CharlyDucrocq/RouletteAuto/README.md

# RouletteAuto
Polytech logo logo polytech

Ce projet est réalisé dans le cadre de la 2ème année de formation de la prépa intégrée de Polytech'Nice Sophia. 

## Description du projet

Le but de ce projet est de concevoir, dévellopper et réaliser une roulette (type casino) qui fonctionnerait automatiquement. Seront alors à immaginer :
- un système de detection de la mise;
- un système de lancement de la roue et de la bille;
- un système de capture du resultat du lancé et de recupération de la bille;
- un système de distribution des éventuelles gains;
