CharlyDucrocq/RouletteAuto/Rapports s-ances/Rapports Charly/Rapport du 19.01.14.md

Déroulement de la séance :

Cette séance et la suivante seront réservé a l'assemblage des differentes pieces de la roue (roue, moteur, capteur, ect...).
En effectuant quelques tests j'ai pu observer que le moteur tourne beaucoup trop vite mais n'as pas la force necessaire afin de (directement) faire tourner doucement la roue avec son poid. De ce fait, il faudra transformer cette vitesse en force a l'aide d'une courroie.
Peu de chose a ajouter, ça reste du bricolage.

Objectif durant la prochaine séance :

- Terminer l'assemblage
- Commencer la programmation
