CharlyDucrocq/RouletteAuto/Rapports s-ances/Rapports Charly/Rapport du 18.12.17.md

Objectif de la séance :

- Experimentation du capteur IR pour la detection de la boule sur modèle en carton 
- Construction representation 3D de la roulette sur Autodesk
- Presparation d'une fonction "pousser" pour le servomoteur qui poussera la boule

Deroulement de la séance :

Les Objectif ont tous était tous était remplie sans difficulté. Le capteur diserne bien la difference entre le trou vide/le scotch noir et la boule (voir image).
Cette séance a plutot était utilisé afin de reflechir à la mise en forme du prototype de la roue et à combinaison de celui ci avec les composant. En effet, sans le prototype rien de concret n'est réaliseable car l'utilisation des composant electonique ne prend sens que conbiné à celle-ci. On a aussi reflechis à la combinaison moteur courantContinue/capteur/"pousseur" et comment faire pour passer d'une étape à l'autre. On a conclue à l'utilisation d'un solenoide pour bloquer la roue.
L'objectif principal pour l'instant sera la conception du prototype. Objectif FabLab ! 

Ci-dessous des image du modele carton et de la modelisation :

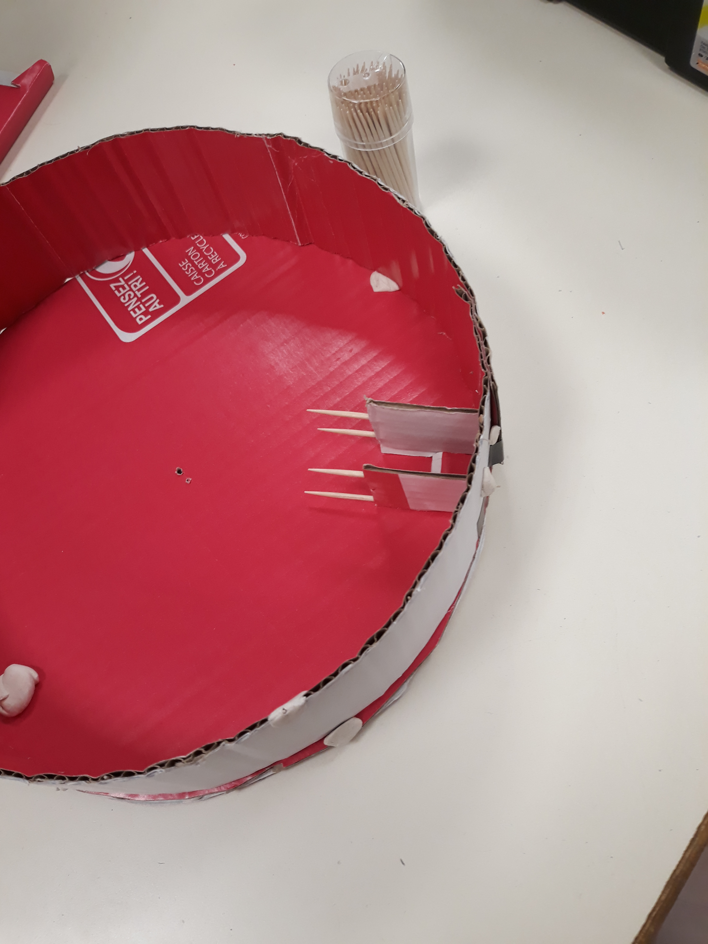
[picture p1: Documents/Images/20181217_164127.jpg]
Modele carton(1)

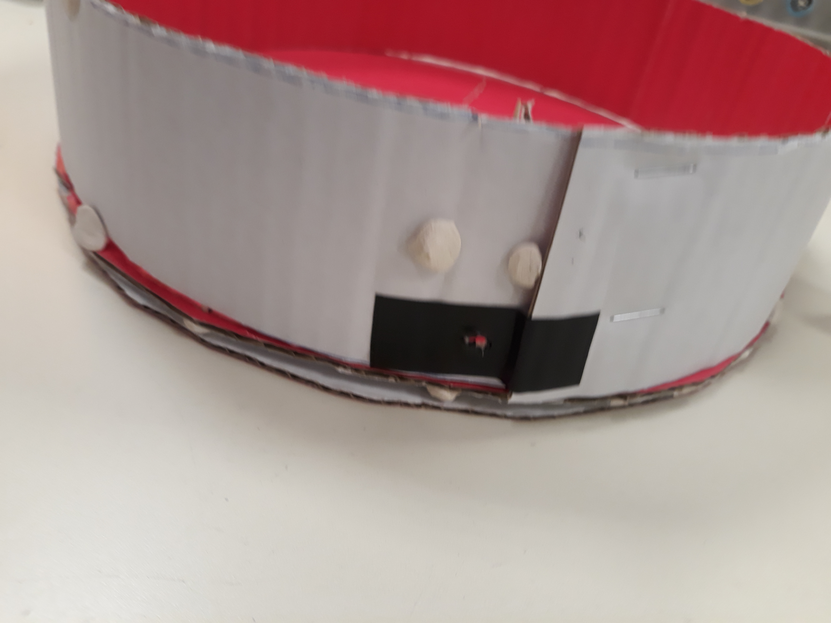
[picture p2: Documents/Images/20181217_164131.jpg]
Modele carton(2)

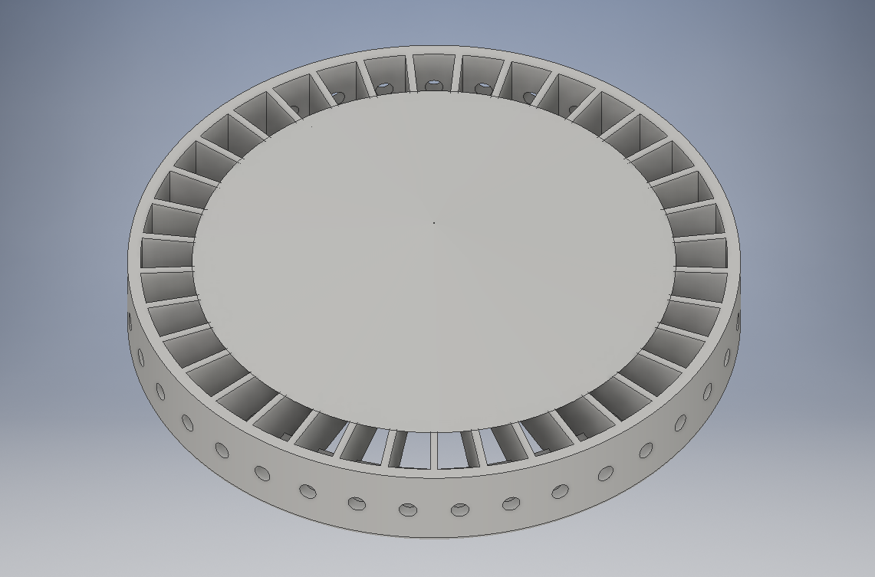
[picture p3: Documents/Images/Capture d’écran (10).png]
Modelisation entier

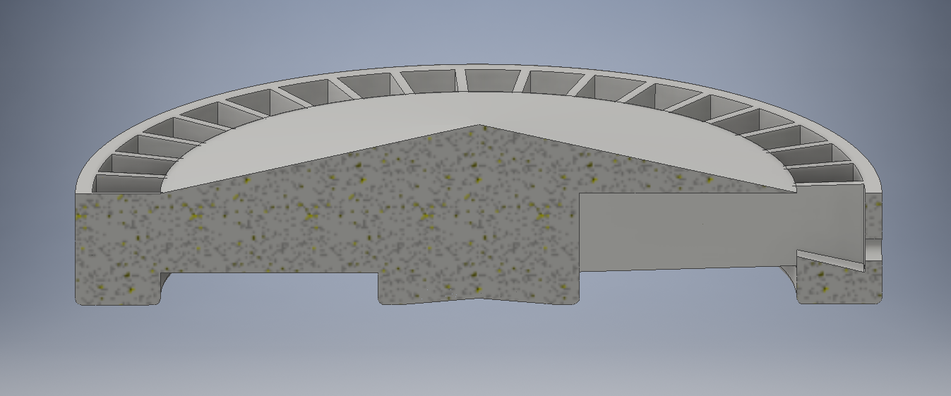
[picture p4: Documents/Images/Capture d’écran (11).png]
Modelisation coupe


Résumé de la séance :

- Experimentation du capteur IR pour la detection de la boule sur modèle en carton  Objectif remplie
- Construction representation 3D de la roulette sur Autodesk                        Objectif remplie
- Presparation d'une fonction "pousser" pour le servomoteur qui poussera la boule   Objectif remplie
