CharlyDucrocq/RouletteAuto/Rapports s-ances/Rapports Charly/Rapport du 19.02.27.md

Deroulement de la scéance :

Toujours dans la continuité des scéance precédente, j'ai avancé sur le prototype :

- j'ai placé les roues qui permettent à la roulette de rouler droit.
- j'ai fixé le capteur de proximité (pour la bille) .
- j'ai testé la pompe. Malheureusement, son souffle est beaucoup trop faible pour pousser la bille. De ce fait, on va devoir revenir à notre idée de base du pousseur.
- Durant cette semaine je compte aussi allé au fablab afin de finaliser la roulette : percer les trous entre capteur et bille et placer les cale en bois (qui permettent à la bille de rester contre la parroi). Il est prevu que j'y aille demain (voir plus bas pour plus d'information concernant son deroulement).
- Depuis la dernière séance, je me suis penché sur la programmation. Cependant, pour l'instant, cela ressemble plus à un croquis de programme car il me manque beaucoup de valeur experimentale que je ne peut pas prendre tant que le prototype n'est pas completé (temps que met la roulette afin que l'aimant passe d'un capteur à un autre, angle de "freinage" quand on arrete le moteur à un certaine vitesse, ...)

Ci-dessous, les photo de l'avancée de l'assemblage post-séance :

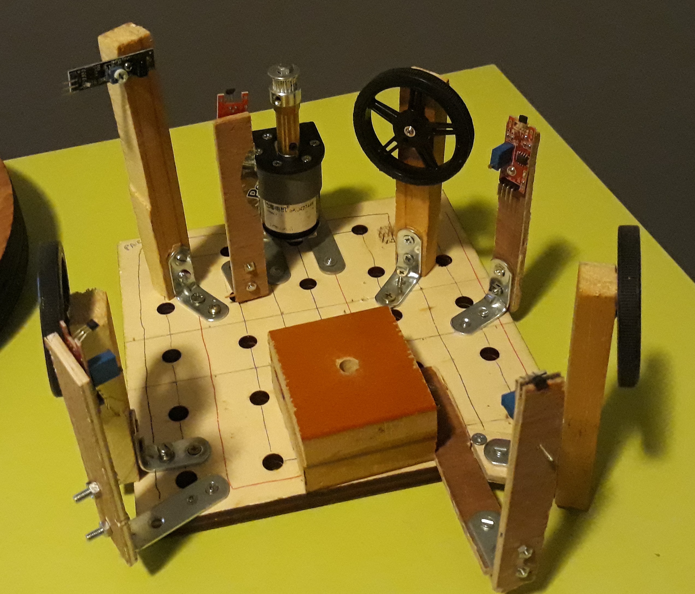
[picture p5: Documents/Images/20190227_194511[1].jpg]
Avancement actuel_sansRoue

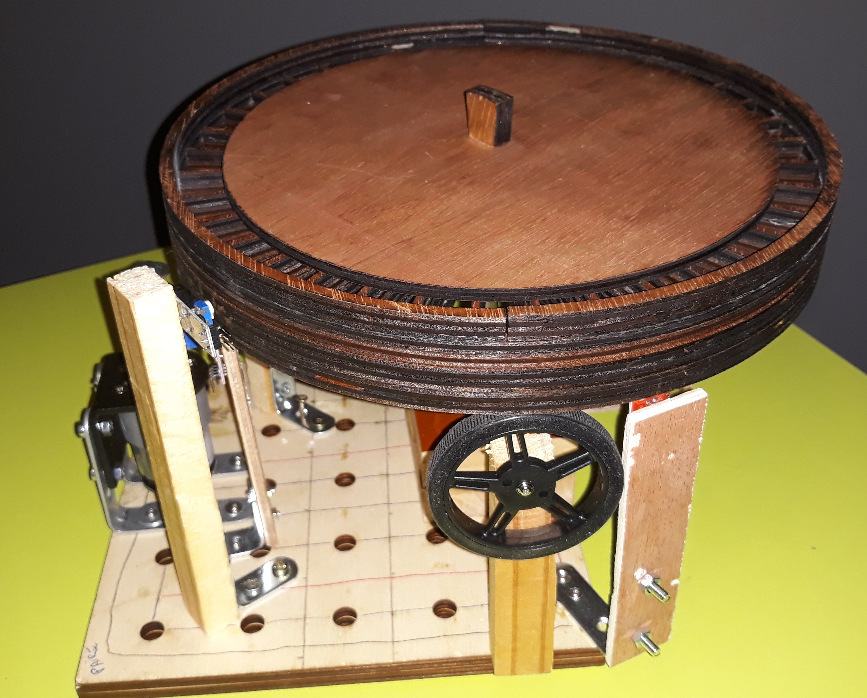
[picture p6: Documents/Images/20190227_194537[1].jpg]
Avancement actuel_avecRoue


Ajout post-fablab :

- Touts les trous sont percés, toutes les cales sont placés, la roulette est terminer (physiquement parlant)! 

Ci-dessous une photo de la roulette post-fablab :

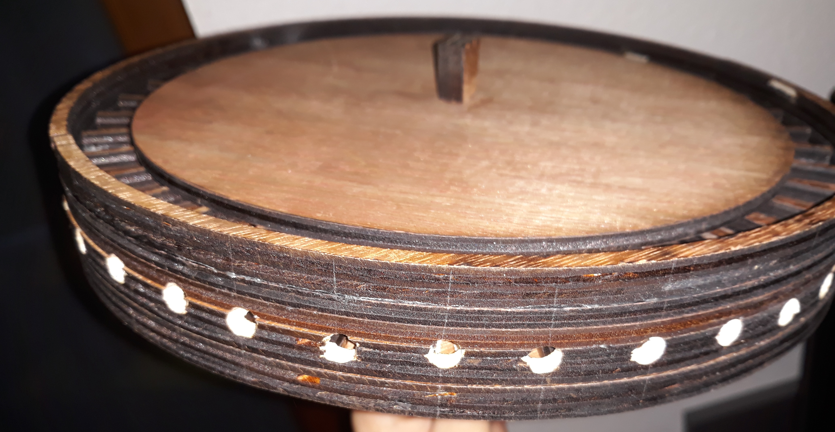
[picture p7: Documents/Images/20190228_182800[1].jpg]
Avancement fablab


Objectif pour la prochaine scéance :

Etant la dernière scéance, le planning s'annonce serré. 
La priorité sera de faire fonctionner un programme qui nous retournera l'emplacement de la bille. 
Pour ce qui est du pousseur, on verra si on a le temps... mais de ce que j'ai vu des différences attente/réalité des temps de production, cela semble compromis.
