CharlyDucrocq/RouletteAuto/Rapports s-ances/Rapports Charly/Rapport du 19.02.13.md

Deroulement de la scéance :

Dans la continuité des scéances précédente, j'ai avancé sur la conception du prototype:
  - J'ai poncé un trou dans lequel j'ai collé l'aimant qui servira de repere pour les capteur. (voir photo)
  - J'ai bricololé et ficé les support des 4 capteurs d'aimant fixé tous les 90° de la roue.
  - Mr. MASSON à reussi à nous procuré une pompe à air pour souffler la bille. Je n'ai pas eu le temps de faire de test de celui-ci mais j'ai de grand espoir quand à son efficacité.

Ce qu'il reste à faire sur la construction : 
- Fixation des roue qui stabiliseront la roulette
- Test et fixation du souffleur
- Fixation du capteur de proximité
- Cablage

Photos de l'avancé du prototype : 

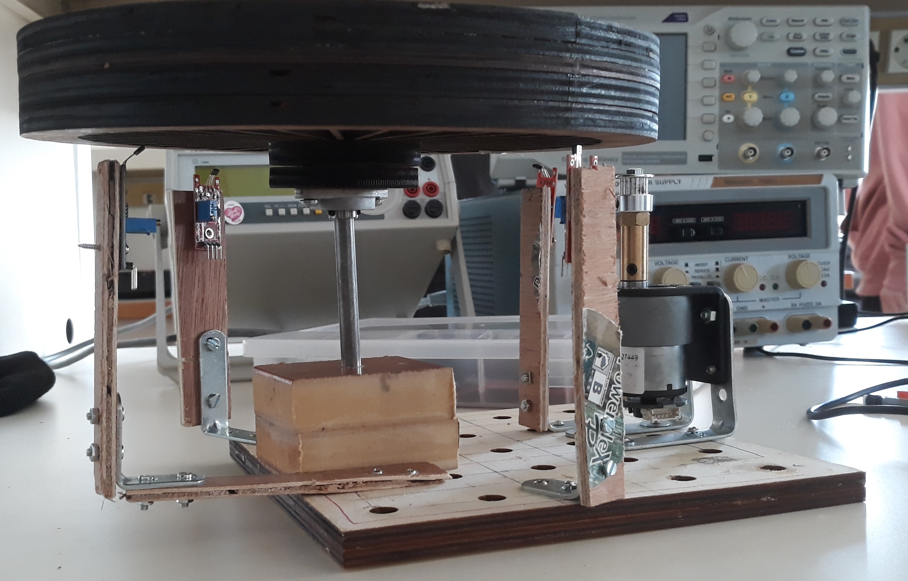
[picture p8: Documents/Images/20190213_125716.jpg]
Avancement actuel_proto

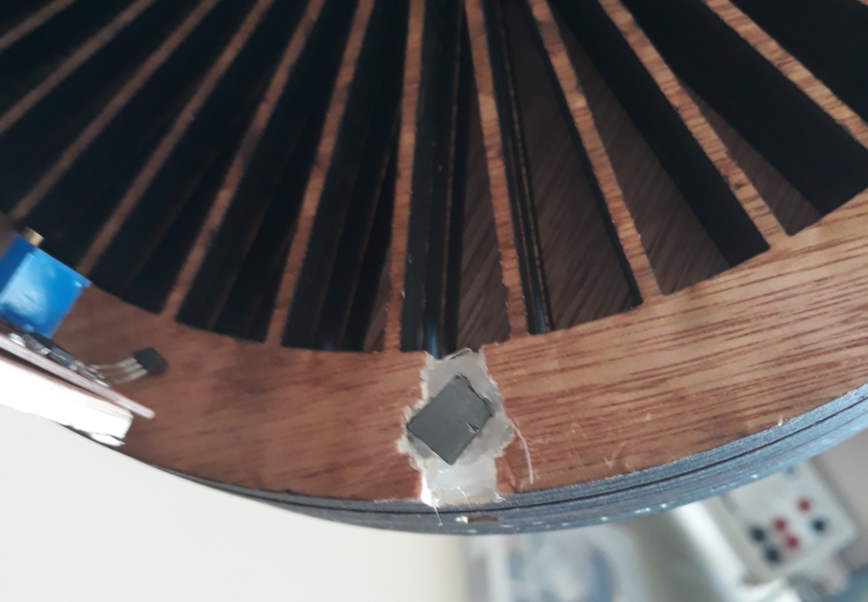
[picture p9: Documents/Images/20190213_125725.jpg]
Avancement actuel_amant
