CharlyDucrocq/RouletteAuto/Rapports s-ances/Rapports Charly/Rapport du 19.02.06.md

Déroulement de la séance :

- Durant cette séance, j'ai continué l'assemblage des pièces. Entre temps, je suis allé au fablab afin de préparer le nécessaire pour l'utilisation de la courroie : decoupe d'un "engrenage" (avec de petite dent pour s'accrocher à la courroie) à fixer sous la roue et ajustement d'une barre de fer qui sera le lien entre le support et le roulement à bille fixé sous la roue.
- La roue est maintenant bien fixé et après quelque essaie, le système de courroie semble apporté une vitesse suffisament lente comme désiré.
- J'ai aussi commencé a creusé un emplacement sous la roue afin d'y placer l'aiment. De plus, du fait de la bancalité du roulement à bille, la roue ne tourne pas toujours parfaitement droite, pour y remedier il faudra placer 2 ou 3 roue sous la roue pour la maintenir. 
- Après reflexion, il m'est aussi venu a l'idée un autre moyen pour éjecter la bille : au lieu d'utiliser un "pousseur" physique qui demandera une grande précision afin de le passer dans le trou, j'ai penser à utiliser un flux d'air qui souflerait la bille, très légère, de son emplacement par ce même trou. Ceci simplifierait grandement le mecanisme car il suffirait de souffler continuellement sur le coté de la roue en la faisant tourner jusqu'à que le souffle passe par le bon trou. Malheureusement, les dispositifs déjà sur place sont trop faible afin de pousser la bille, il faudrait donc trouver et commander un autre dispositif plus puissant ou sinon revenir sur l'idée précedente du "pousseur".

Ci-dessous des photos de l'assemblage jusqu'à maintenant :

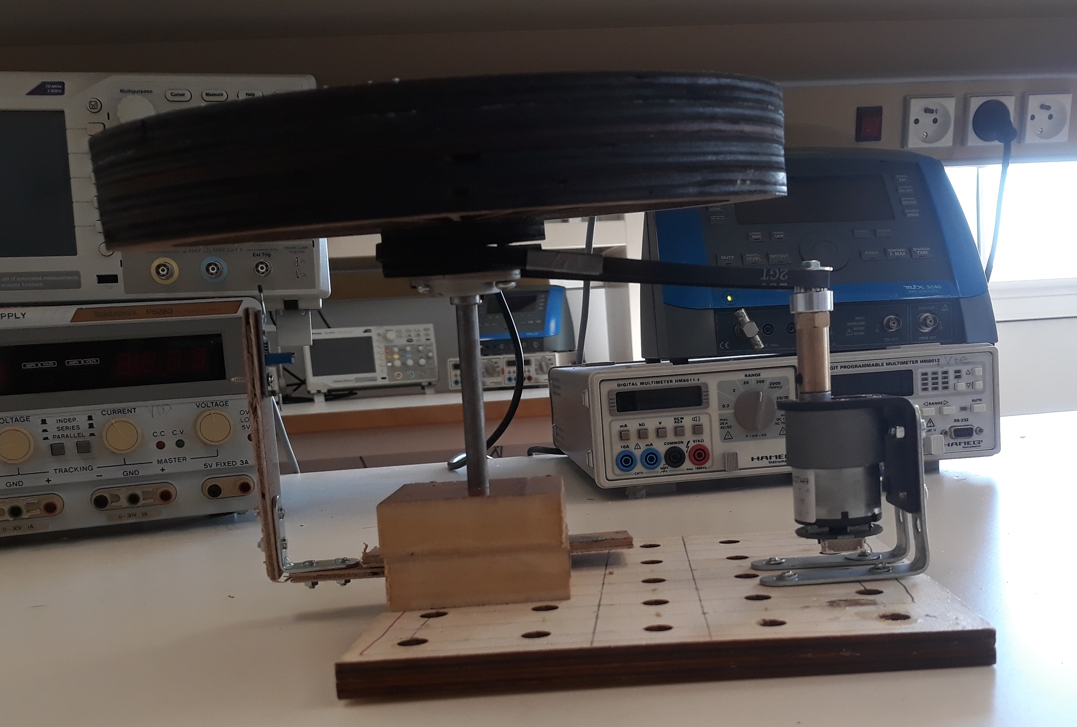
[picture p10: Documents/Images/20190206_131537.jpg]
Avancement actuel_1

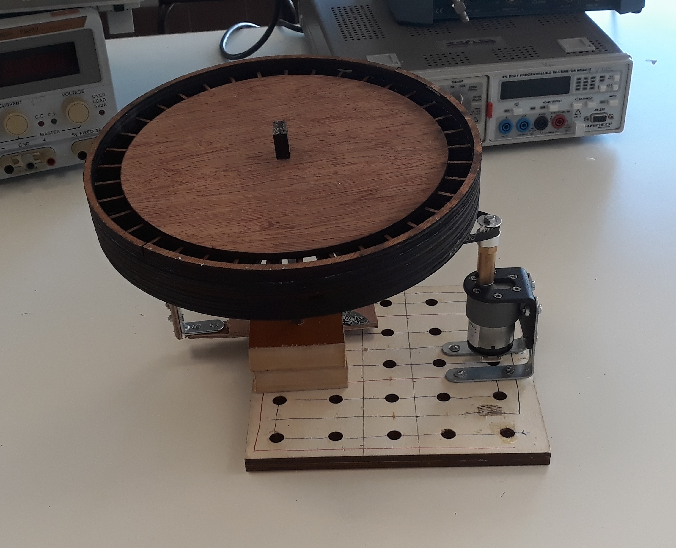
[picture p11: Documents/Images/20190206_131543.jpg]
Avancement actuel_2
