CharlyDucrocq/RouletteAuto/Rapports s-ances/Rapports Charly/Rapport du 19.01.09.md

Objectif de la séance :

- Preparation des patron pour la construction du prototype

Deroulement de la séance :

Un rdv au fablab a était prevue pour le mardi 10/01. en vue de l'optimisation de son utilisation, la séance a été dans mon cas alloué à sa preparation. Au départ j'étais partie sur des patron papier, pensant que la decoupe se ferait a la main. Cependant, au conseil d'un collegue, je me suis orienter vers un logiciel appelé Inkscape, permettant d'utiliser la decoupeuse laser.  

Ci-dessous des image Inkscape :

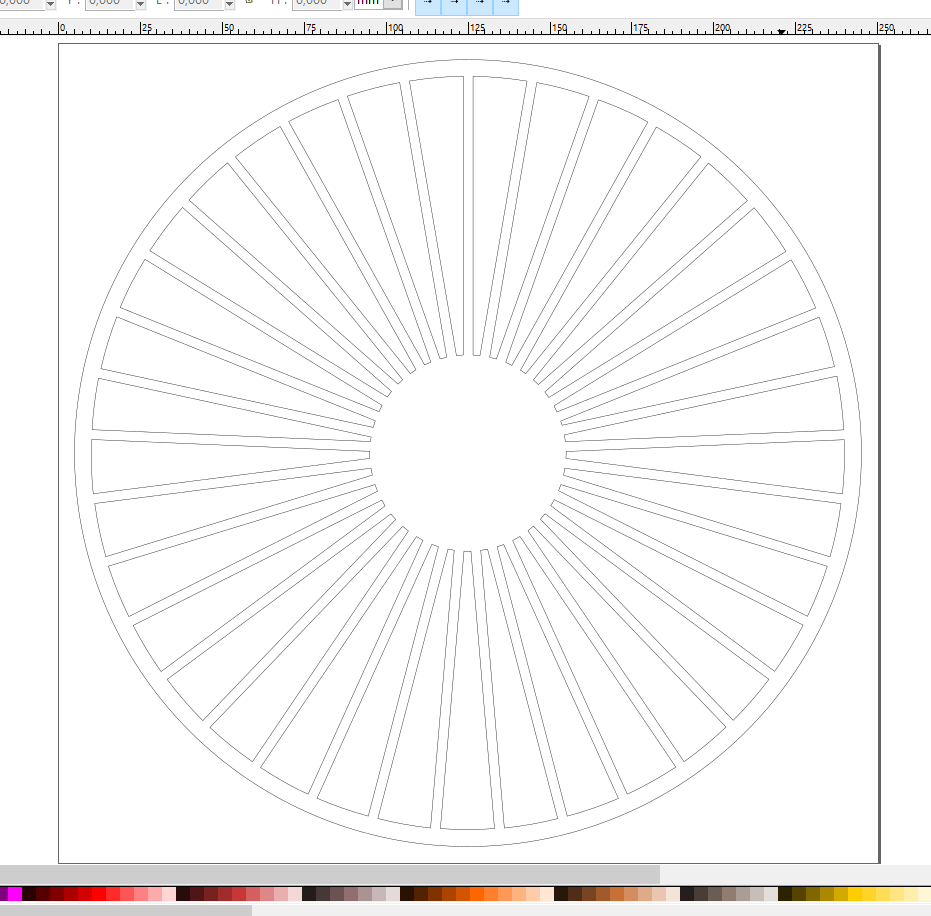
[picture p12: Documents/Images/Capture d’écran (14).png]
Roue interne

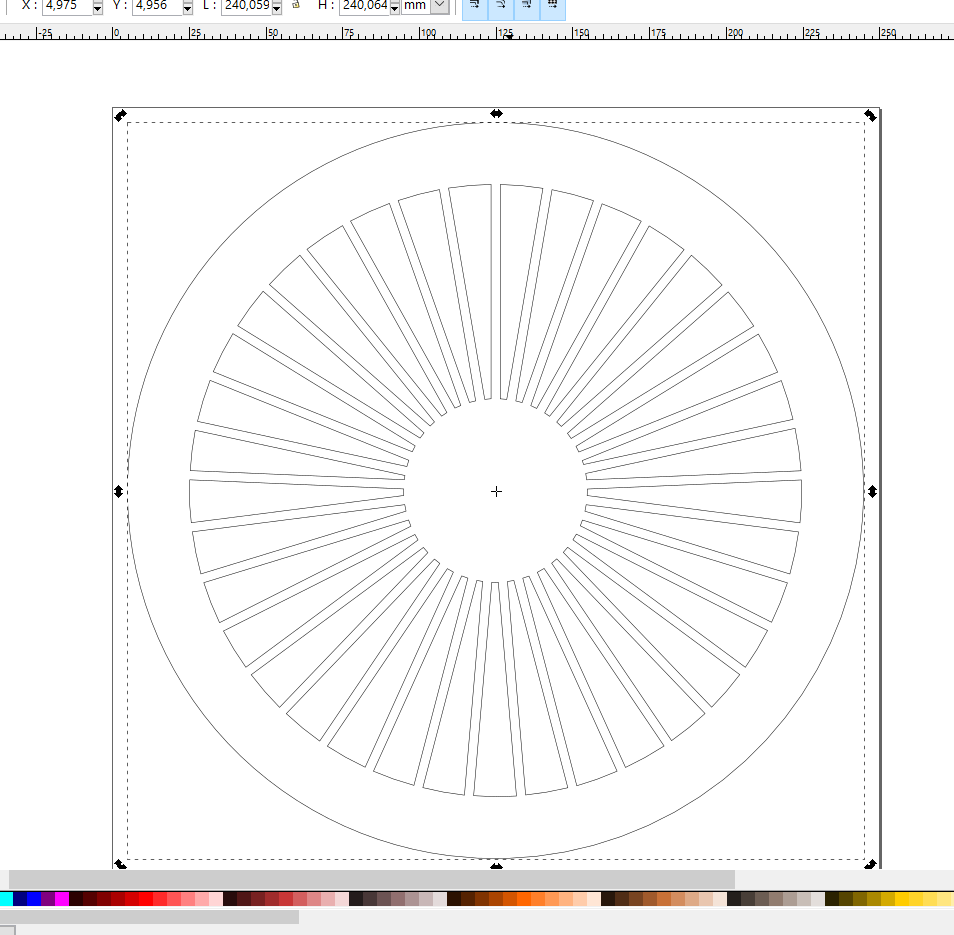
[picture p13: Documents/Images/Capture d’écran (13).png]
Roue dessous


----------------------------------------------------

Ajout post-fablab du 10/01:

La preparation du prototype a bien avancé. Il ne manque plus qu'un etage pour atteindre une hauteur suffisante. Un nouveau rdv a été pris pour le 12/01 afin de finir ce qui reste.

Ajout post-fablab du 12/01:

La roue est "terminé", il ne manque plus qu'a faire les trou et coller les cale (afin de maintenir la bille vers le trou, j'utilise les triangle qui sont rester de la decoupe) que je ferais après quelque essai de peur de faire des erreurs irreversibe. 
De plus, j'ai commandé et reçu des bille en plastique de 9 mm de diametre.
Enfin, j'ai aussi decoupé un petit "crochet" qui permettra d'ejecter les bille.

Ci-dessous les photos prise lors du fablab :

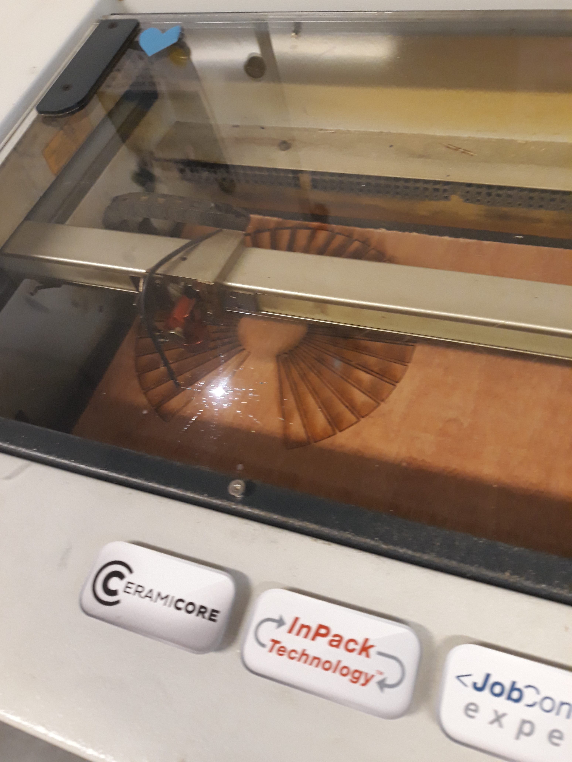
[picture p14: Documents/Images/20190108_152826.jpg]
Decoupe

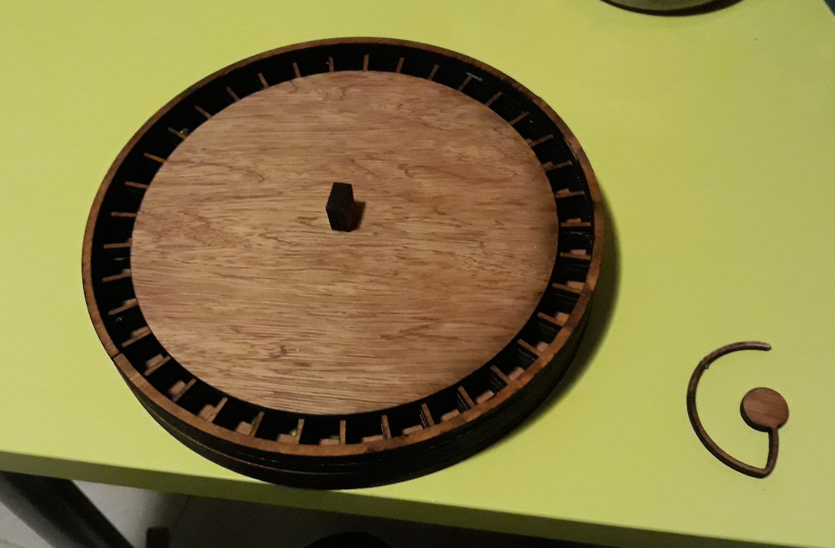
[picture p15: Documents/Images/20190111_074810.jpg]
Resultat
