CharlyDucrocq/RouletteAuto/Rapports s-ances/Rapports Charly/Rapport du 18.12.10.md

Objectif de la séance :

- Recherche et experimentation du fonctionnement du capteur couleur;
- Determination du temps min de capture du capteur;
- Recherche et experimentation du fonctionnement du capteur d'aiment;

Deroulement de la séance :

Le capteur d'aiment a été compris sans difficulté, il est prêt à être utilisé quand il sera necessaire.
Concernant le capteur de couleur, la comprehension de son fonctionnement est encore flou. Des fonction arduino ont était réalise afin de differencier les jetons mais aucun test concernant son temps d'action n'a était à proprement parlé réalisé. Cependant, d'après de très rapide observation, on peut supposer qu'un arrêt devra très certainement être réaliser pour que le capteur puisse faire son travail. Affirmation à confirmer à la prochaine séance.

Résumé de la séance :

- Recherche et experimentation du fonctionnement du capteur d'aiment;  Objectif remplie
- Recherche et experimentation du fonctionnement du capteur couleur;   Objectif presque remplie
- Determination du temps min de capture du capteur;                    Objectif non-remplie
