CharlyDucrocq/RouletteAuto/Presentation.pdf

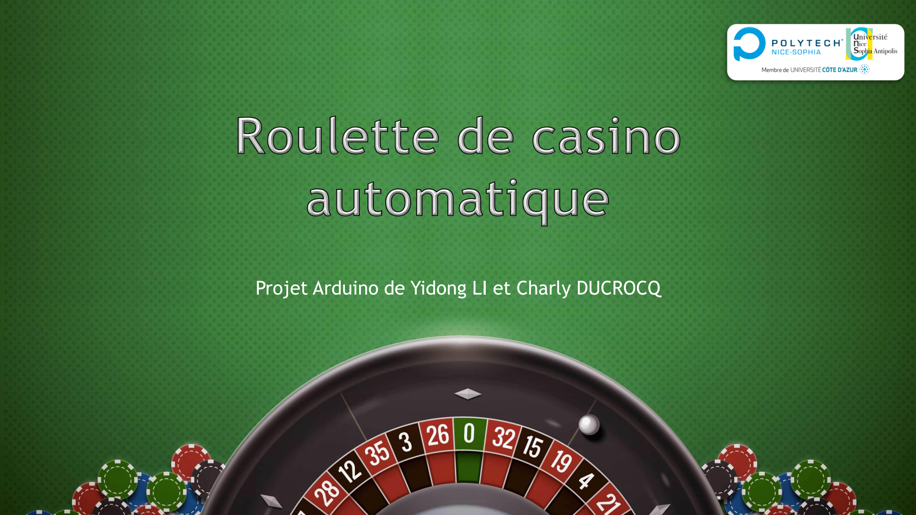
[picture p32: page 1]

## Projet Arduino de Yidong LI et Charly DUCROCQ

# SOMMAIRE

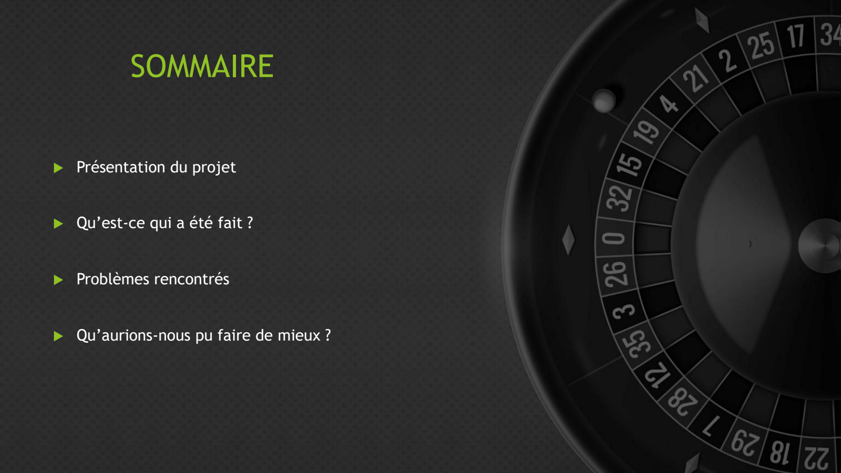
[picture p33: page 2]

## - Présentation du projet

## - Qu’est-ce qui a été fait ?

## - Problèmes rencontrés

## - Qu’aurions-nous pu faire de mieux ?

## - Présentation du projet

## - OBJECTIFS :

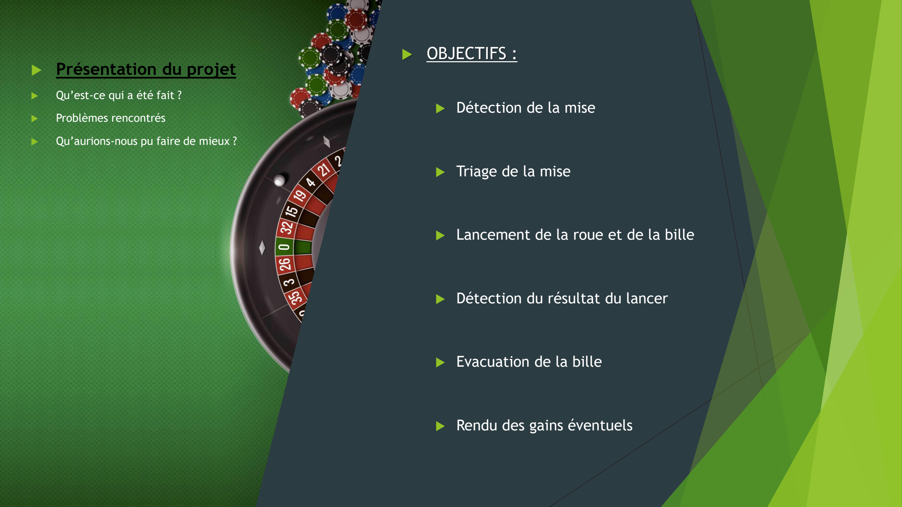
[picture p34: page 3]

- Qu’est-ce qui a été fait ?
- Problèmes rencontrés
- Qu’aurions-nous pu faire de mieux ?

## - Détection de la mise

## - Triage de la mise

## - Lancement de la roue et de la bille

## - Détection du résultat du lancer

## - Evacuation de la bille

## - Rendu des gains éventuels

## - Qu’est-ce qui a été fait ?

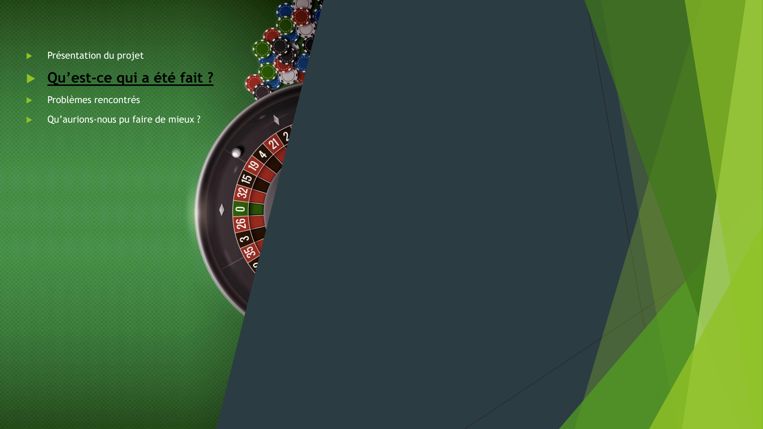
[picture p35: page 4]

- Présentation du projet
- Problèmes rencontrés
- Qu’aurions-nous pu faire de mieux ?

## - Problèmes rencontrés

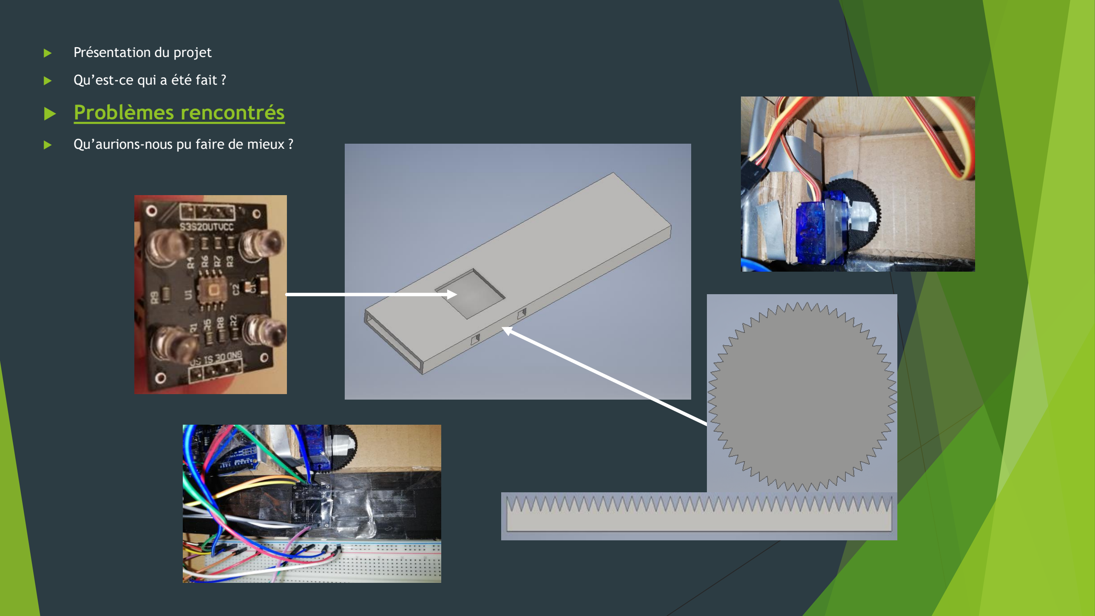
[picture p36: page 5]

- Présentation du projet
- Qu’est-ce qui a été fait ?
- Qu’aurions-nous pu faire de mieux ?

## - Problèmes rencontrés

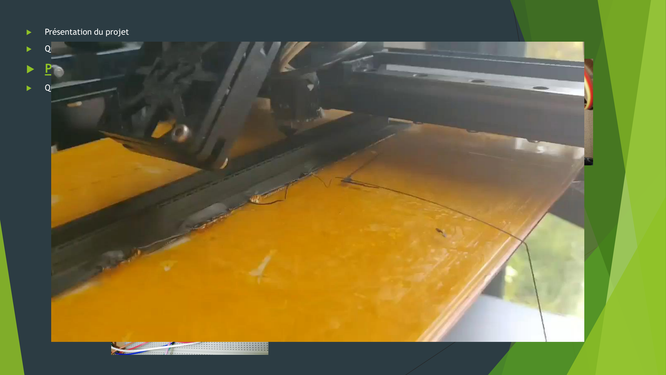
[picture p37: page 6]

- Présentation du projet
- Qu’est-ce qui a été fait ?
- Qu’aurions-nous pu faire de mieux ?

## - Problèmes rencontrés

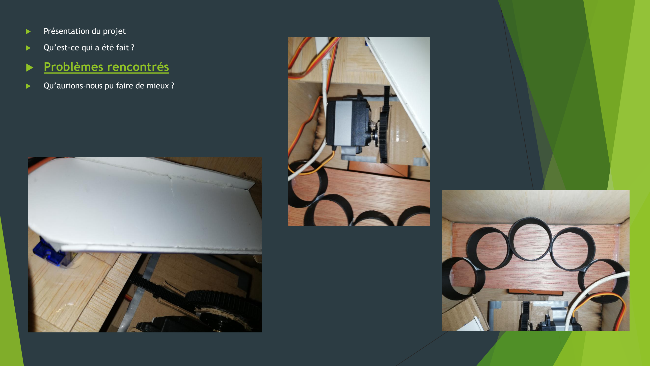
[picture p38: page 7]

- Présentation du projet
- Qu’est-ce qui a été fait ?
- Qu’aurions-nous pu faire de mieux ?

## - Présentation du projet

# Jeton avec couleur

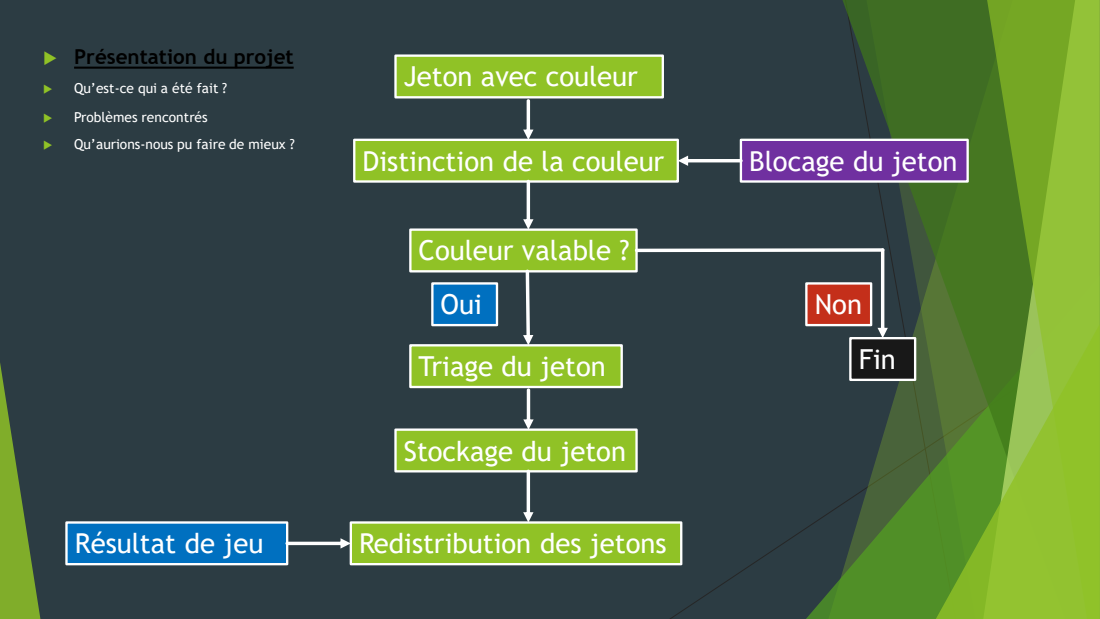
[picture p39: page 8]
Problèmes rencontrés; Distinction de la couleur; Blocage du jeton; Couleur valable ?; Oui; Non; Résultat de jeu; Redistribution des jetons; Fin

Qu’est-ce qui a été fait ?

Qu’aurions-nous pu faire de mieux ?

Triage du jeton

Stockage du jeton

## - Problèmes rencontrés

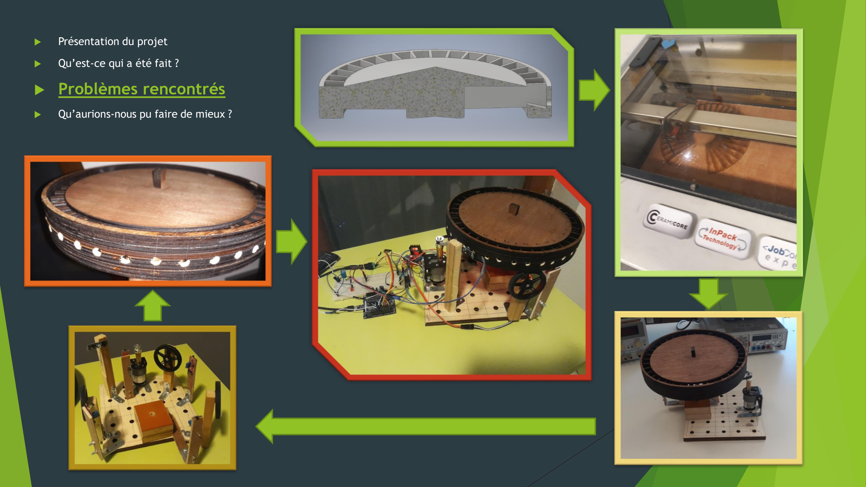
[picture p40: page 9]
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

## - Présentation du projet

# Traitement

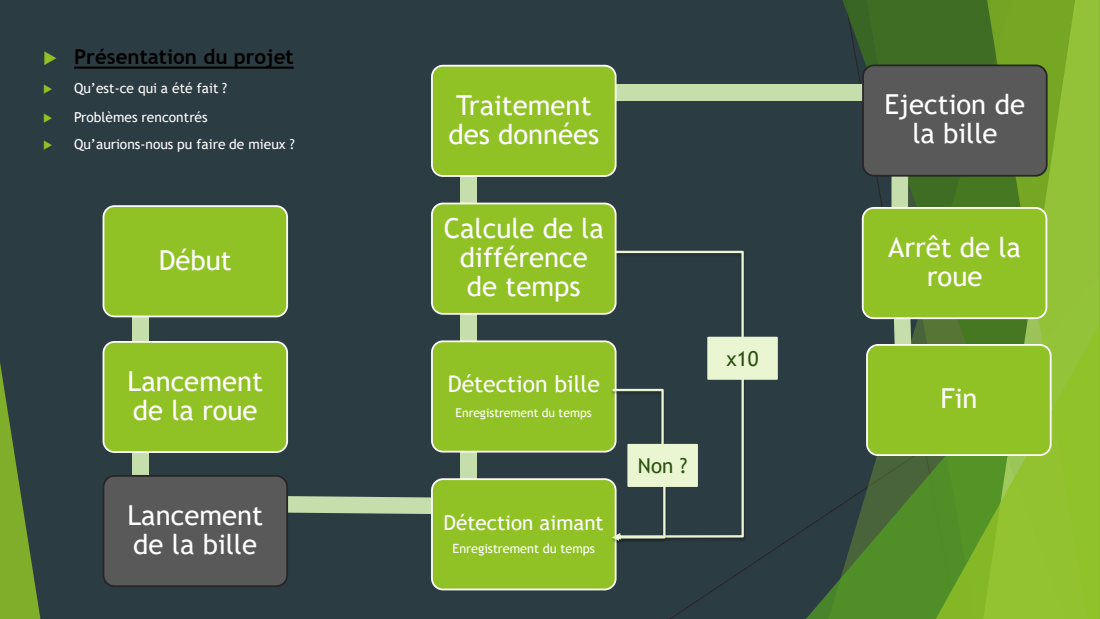
[picture p41: page 10]
Problèmes rencontrés; Début; Détection aimant; Détection bille; des données; Ejection de la bille; Fin; Non ?

Qu’est-ce qui a été fait ?

Qu’aurions-nous pu faire de mieux ?

Calcule de la
différence
de temps

Arrêt de la
roue

Lancement
de la roue

Enregistrement du temps

de la bille

## - Présentation du projet

# Traitement

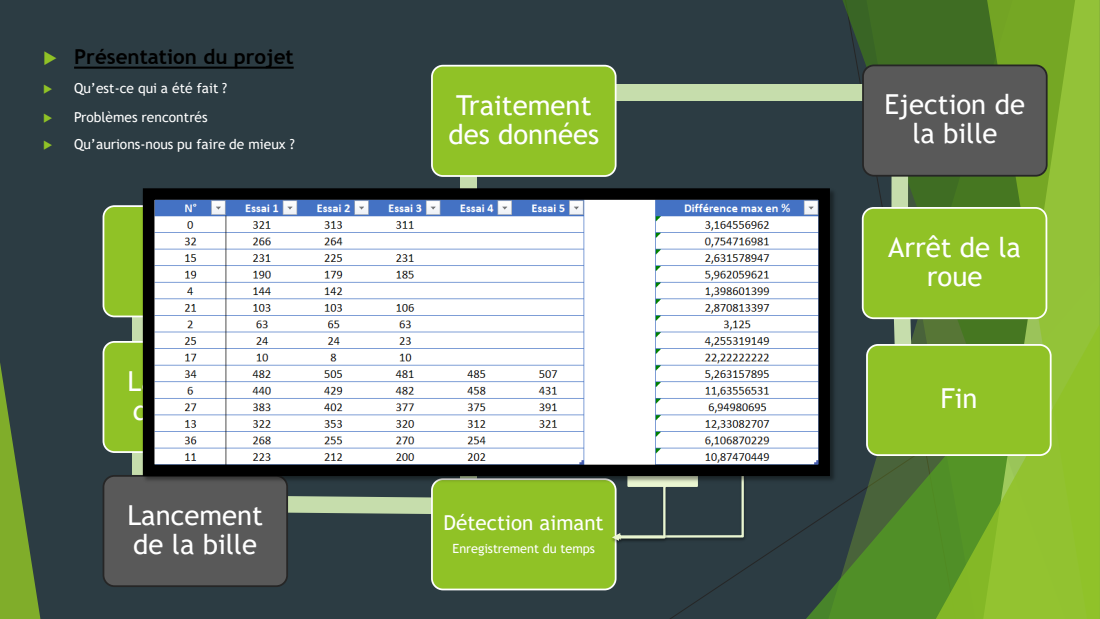
[picture p42: page 11]
Problèmes rencontrés; Début; Détection aimant; Détection bille; des données; Ejection de la bille; Fin; Non ?

Qu’est-ce qui a été fait ?

Qu’aurions-nous pu faire de mieux ?

Calcule de la
différence
de temps

Arrêt de la
roue

Lancement
de la roue

Enregistrement du temps

de la bille

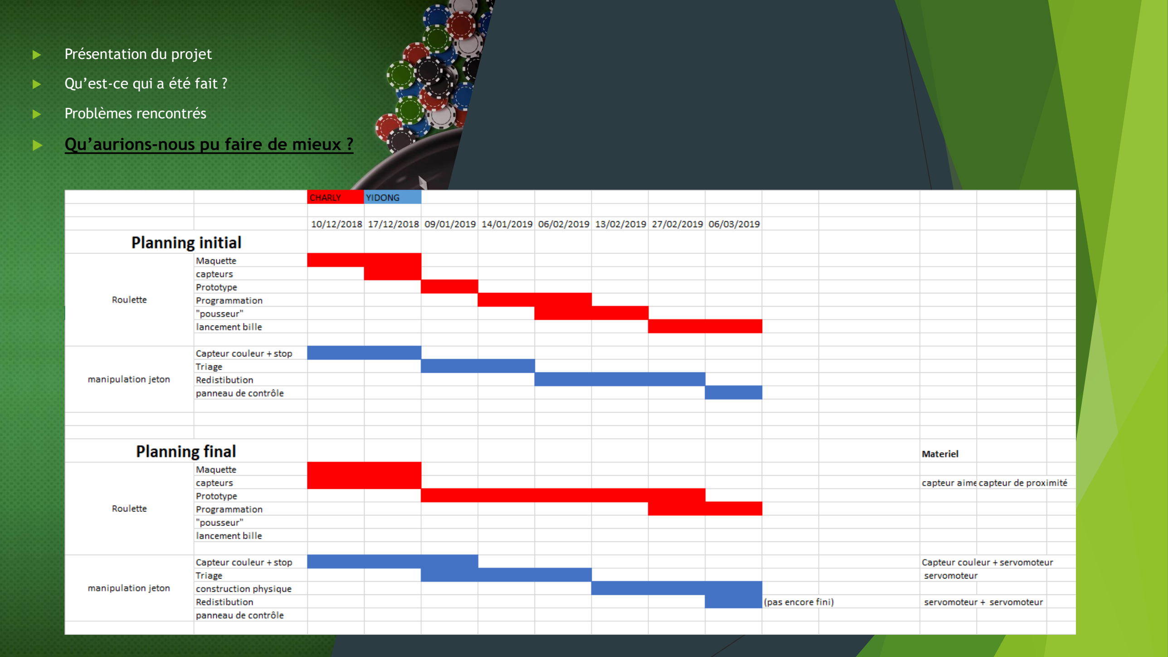
[picture p43: page 12]

- Présentation du projet
- Qu’est-ce qui a été fait ?
- Problèmes rencontrés
- Qu’aurions-nous pu faire de mieux ?

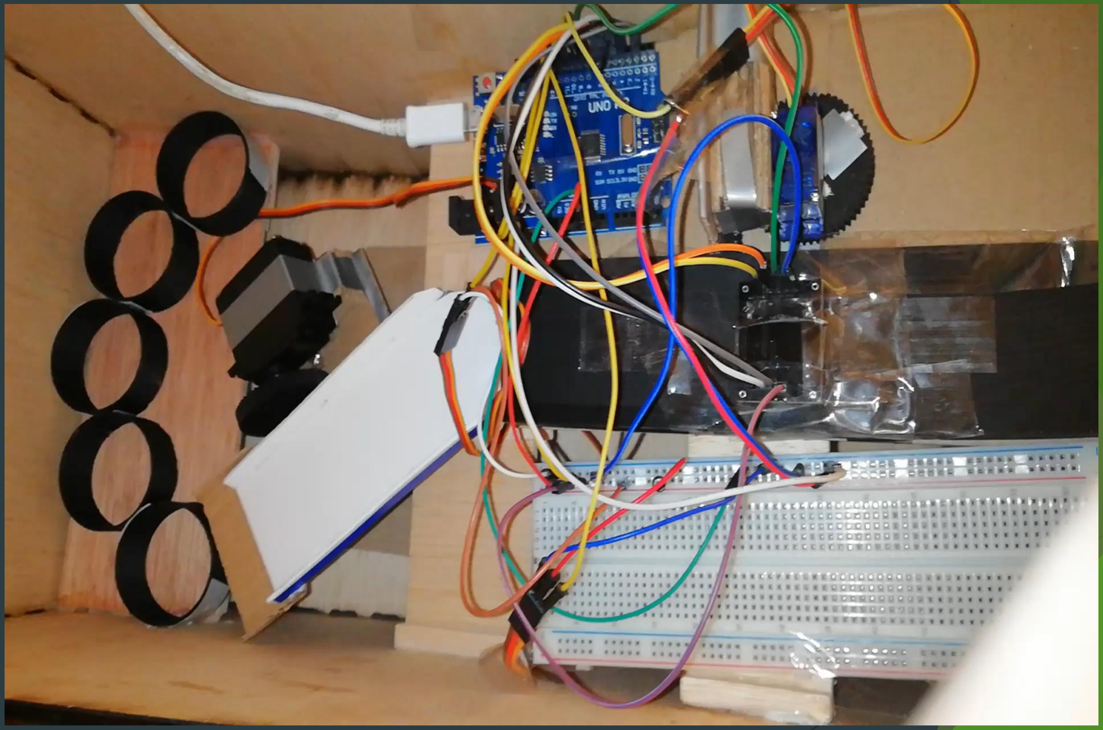
[picture p44: figure]

# Video

## Lien vers le github du projet :

## https://github.com/CharlyDucrocq/RouletteAuto

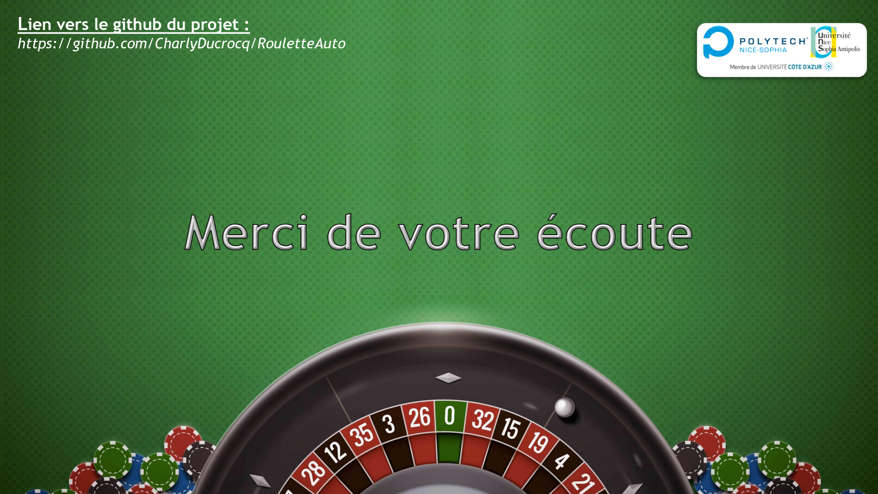
[picture p45: page 14]
