CharlyDucrocq/RouletteAuto/Documents/Images/capteur de couleur.jpg

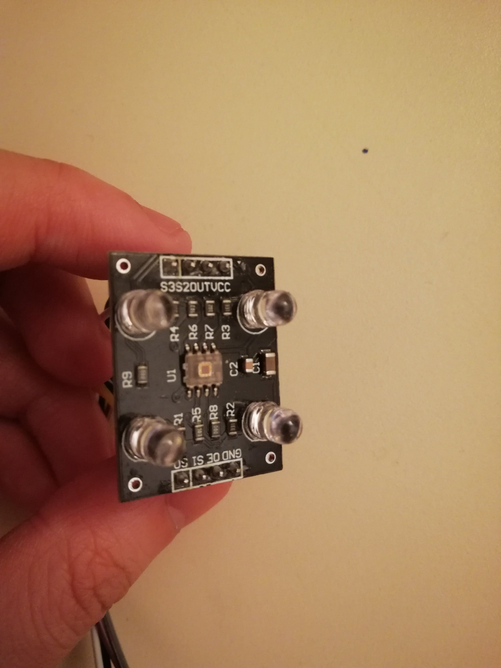
Documents/Images/capteur de couleur.jpg
