CharlyDucrocq/RouletteAuto/Documents/Images/servo-moteur PARALLAX continuous rotatrion.jpg

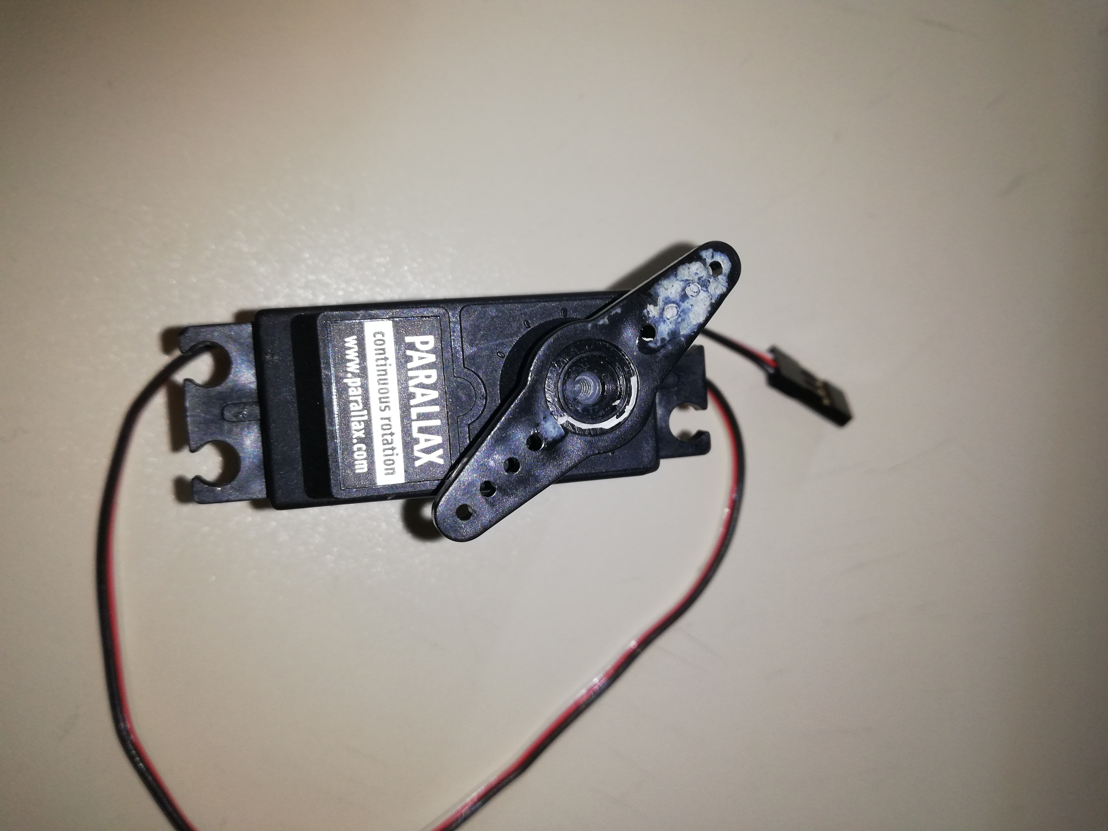
Documents/Images/servo-moteur PARALLAX continuous rotatrion.jpg
