CharlyDucrocq/RouletteAuto/Documents/Images/Système de de triage(1).jpg

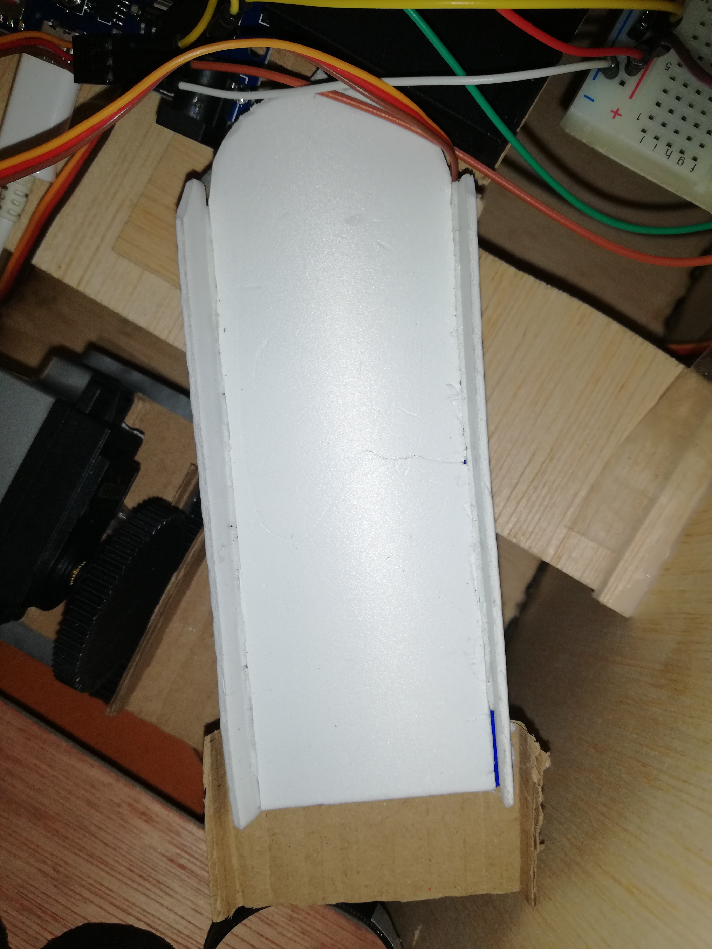
Documents/Images/Système de de triage(1).jpg
