CharlyDucrocq/RouletteAuto/Documents/Images/Système de redisreibution.jpg

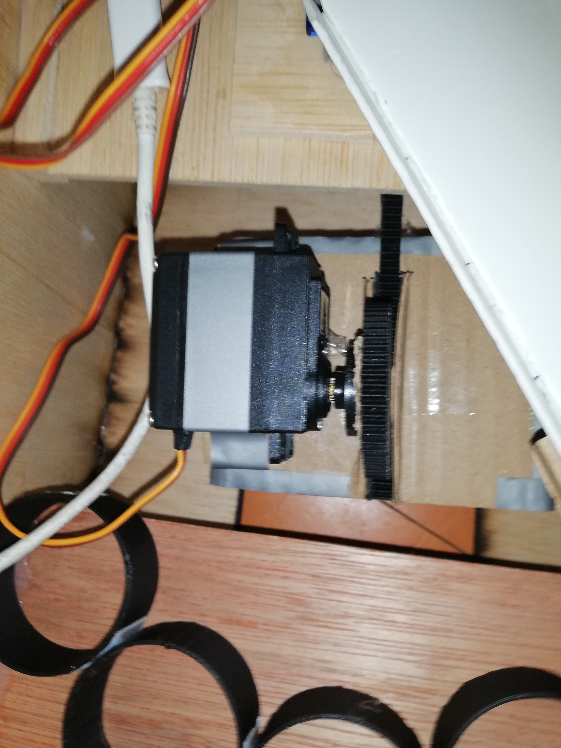
Documents/Images/Système de redisreibution.jpg
