CharlyDucrocq/RouletteAuto/Documents/Images/Système de Triage partie(3).jpg

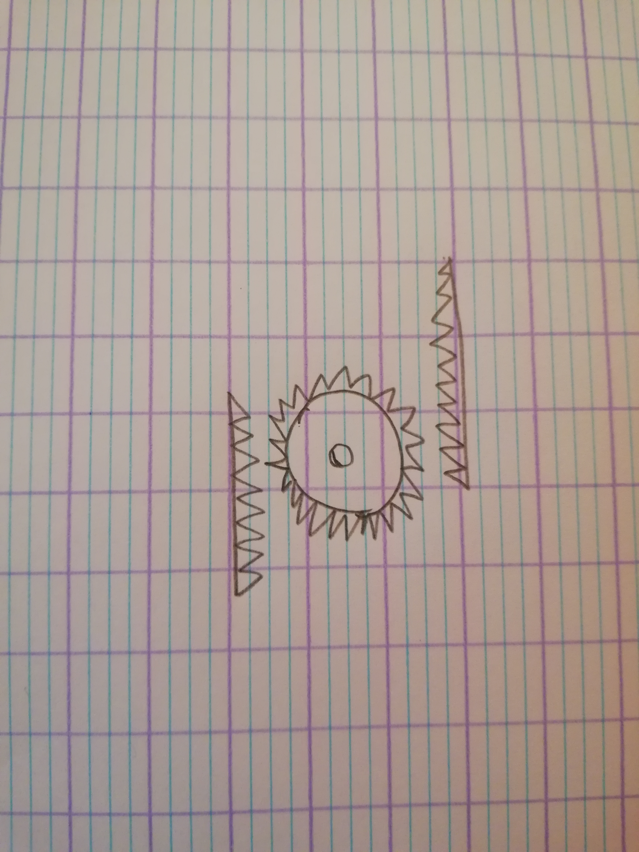
Documents/Images/Système de Triage partie(3).jpg
