CharlyDucrocq/RouletteAuto/Documents/Images/Système de triage.jpg

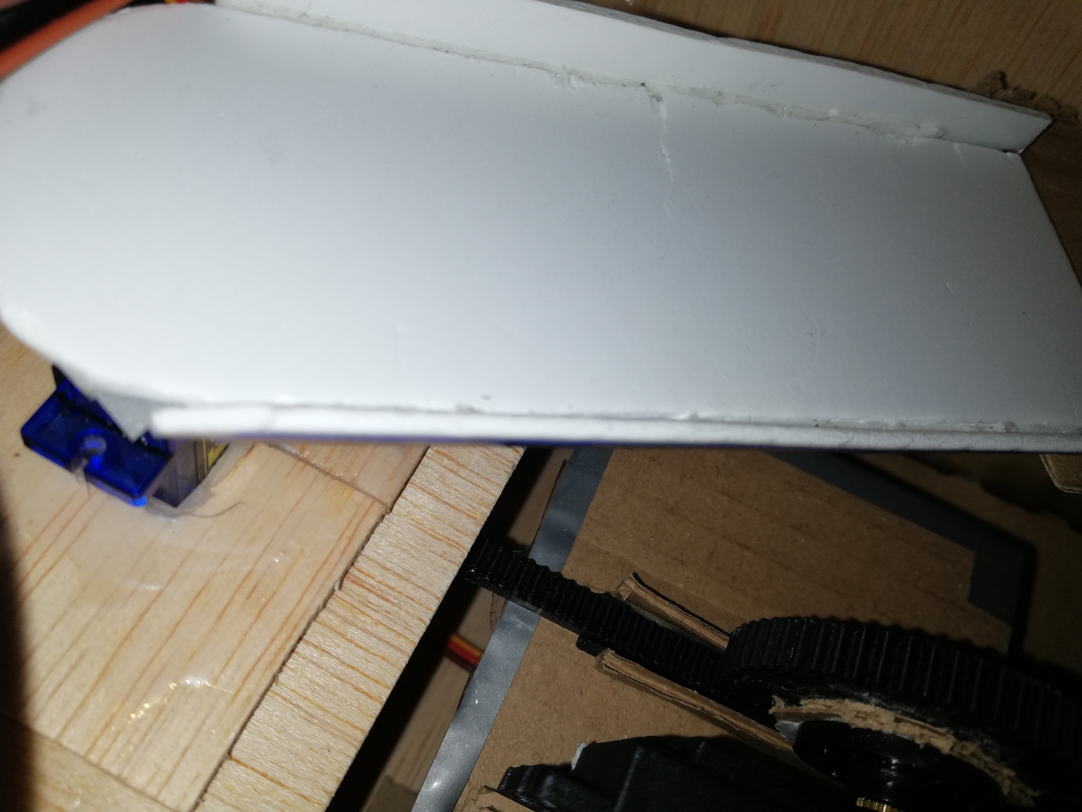
Documents/Images/Système de triage.jpg
