CharlyDucrocq/RouletteAuto/Documents/Images/Système de Triage.png

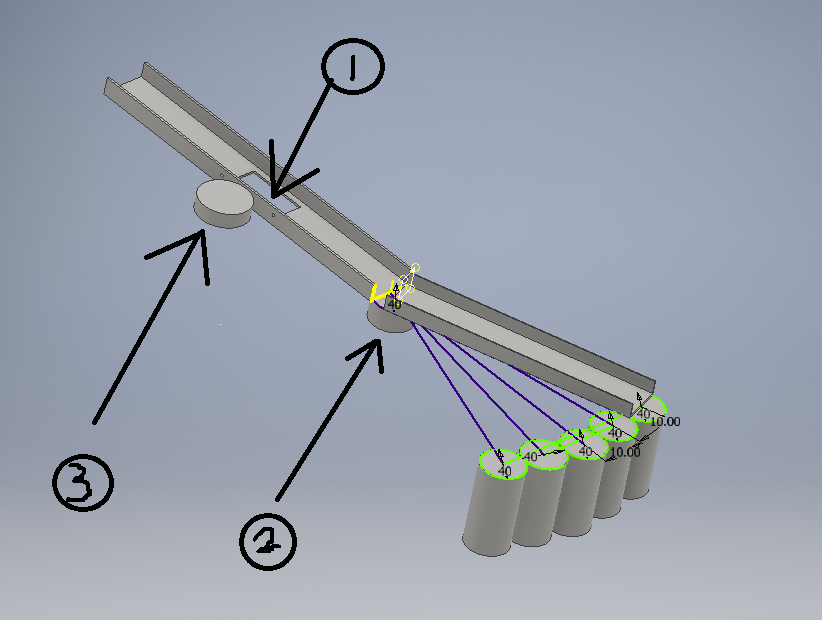
Documents/Images/Système de Triage.png
