CharlyDucrocq/RouletteAuto/Documents/Images/construction physique.jpg

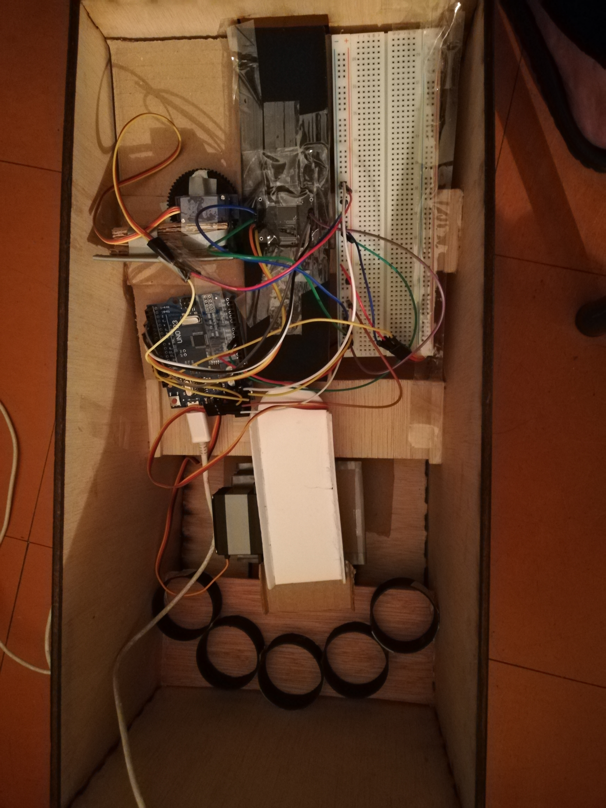
Documents/Images/construction physique.jpg
